juancbarraganp/PROYECTO-SEMINARIO-2026-ECCI/2. Conexiones eléctricas/Tapa Tablero.pdf

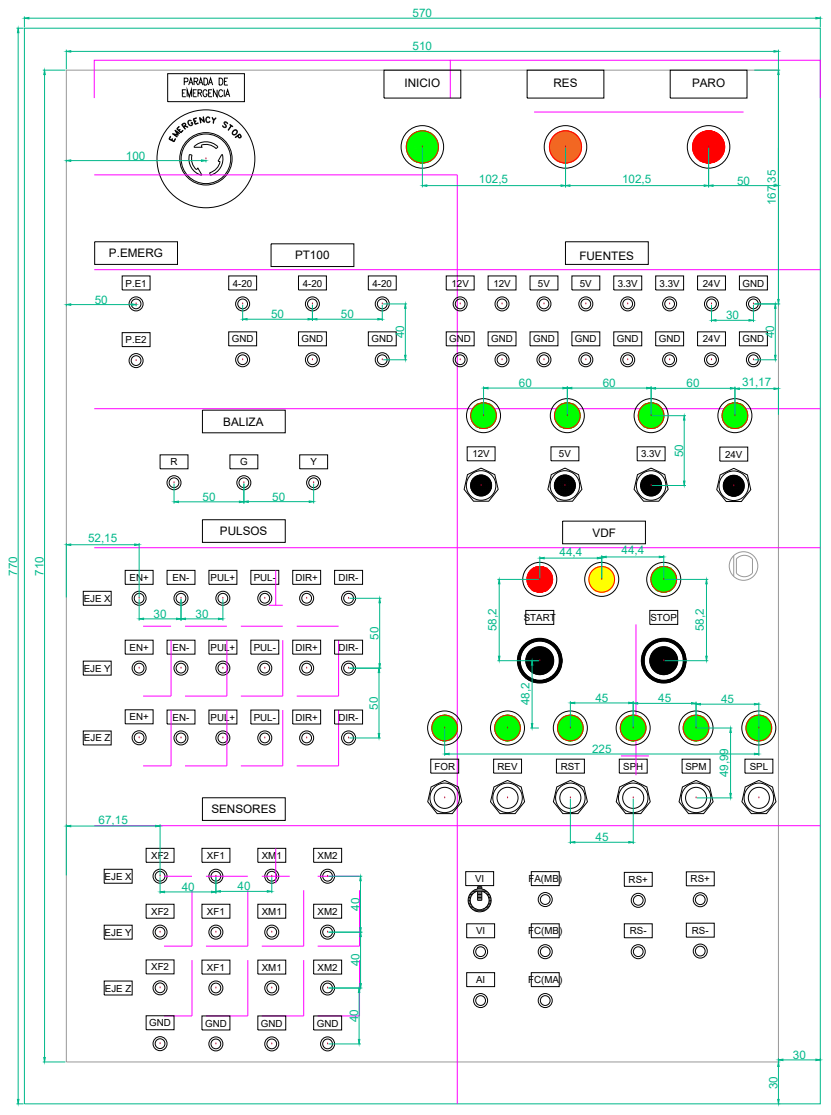
[picture p37: page 1]
INICIO; RES; PARO P.E2 P.E1; PUL+ PUL+; PUL- PUL- EN+; PUL+; PUL- EJE X EJE Y EJE Z; 4-20 GND; 4-20 GND 4-20 GND PULSOS SENSORES; FUENTES BALIZA; VDF 12V GND; 12V GND; 5V GND; 3.3V GND; GND 24V; GND 12V; 24V FOR; REV; RST; SPH; SPM START; STOP VI; XM2 EJE X EJE Y EJE Z P.EMERG; DIR+ DIR+ DIR+; DIR- DIR- DIR- GND; GND; SPL
