juancbarraganp/PROYECTO-SEMINARIO-2026-ECCI/2. Conexiones eléctricas/Planos_seminario_.pdf

| | | | 10/04/2026 | EPLAN Planos electricos proyecto seminario | Universidad ECCI | =
| | | Resp. | juanc | | | +
| | | Probado | | | | 1 | Hoja 0. Portada
Cambio | Fecha | Nombre | Original | | Sustituido por | Sustituido por | | | Página 1 / 13

0

# 1. Distribucion breacker

1 | 2 | 3 | 4 | 5 | 6 | 7 | 8 | 9

# DIAGRAMA ELECTRICO GABINETE DE CONTROL

# INPUT

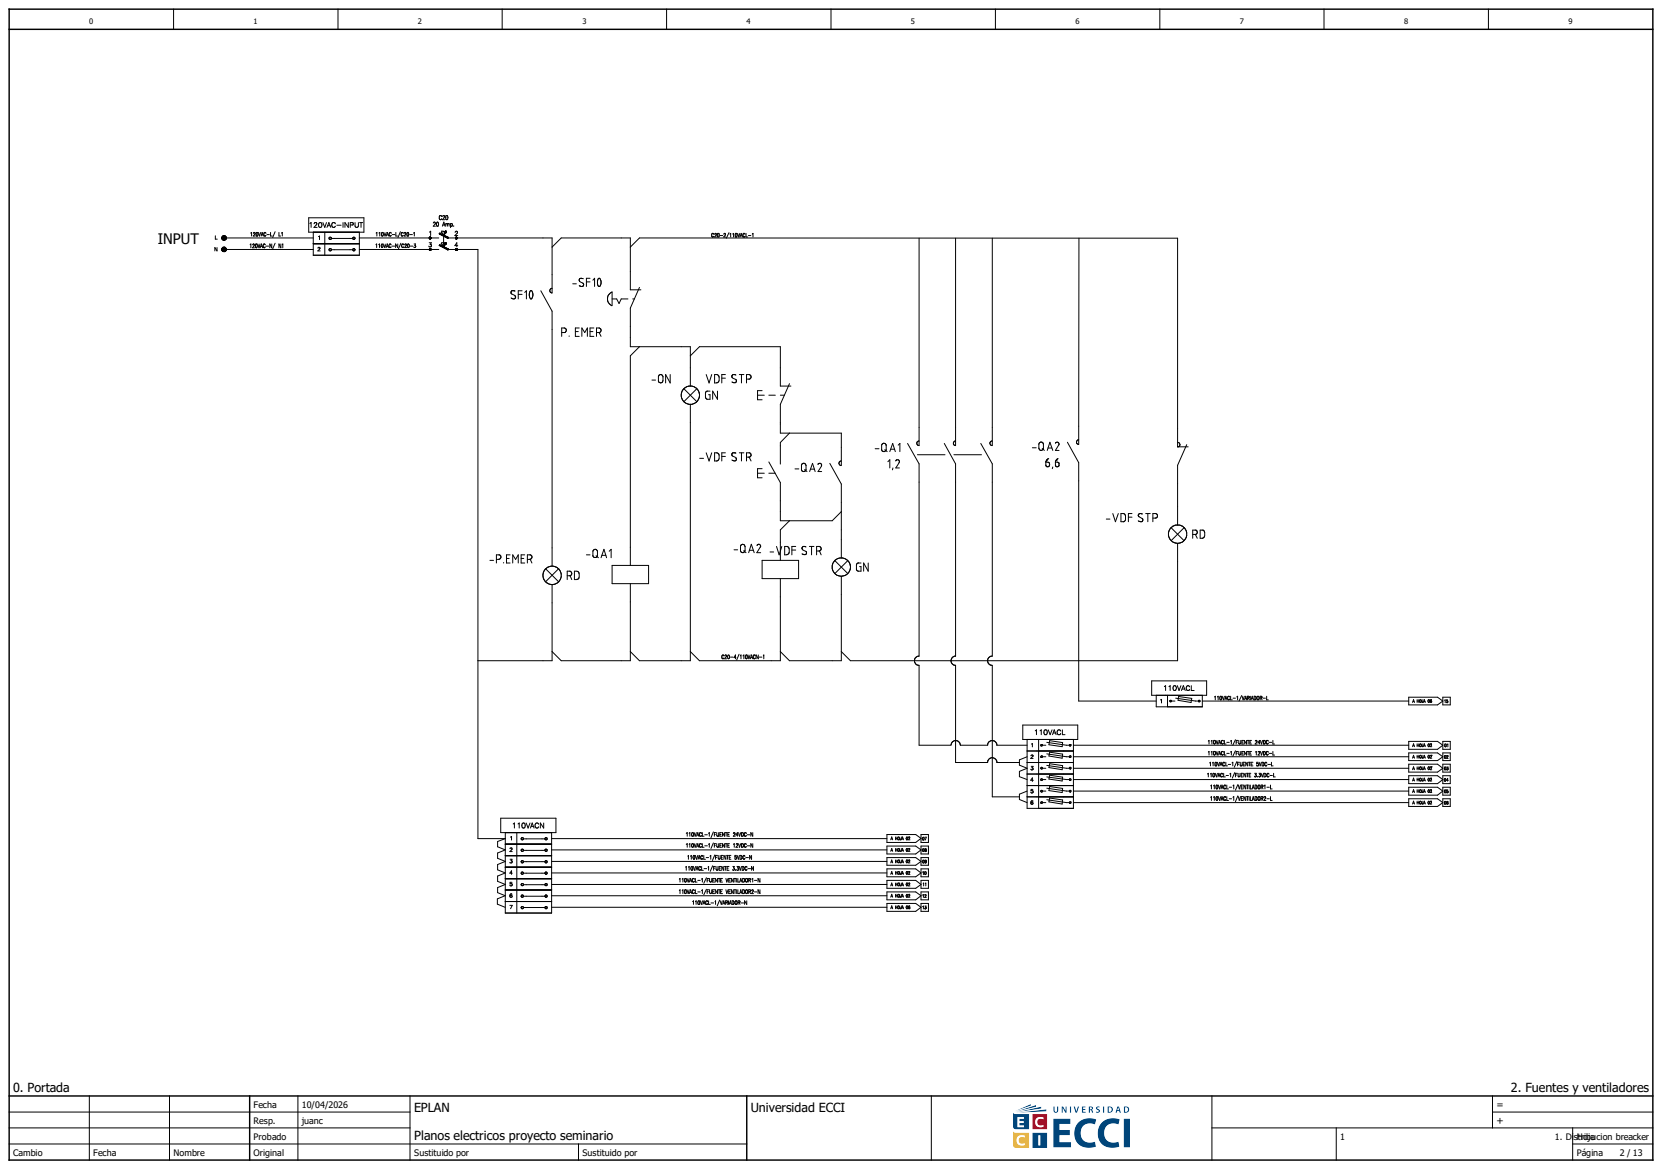
[picture p38: page 2]
0. Portada; 2. Fuentes y ventiladores; 1. Distribucion breacker; Página

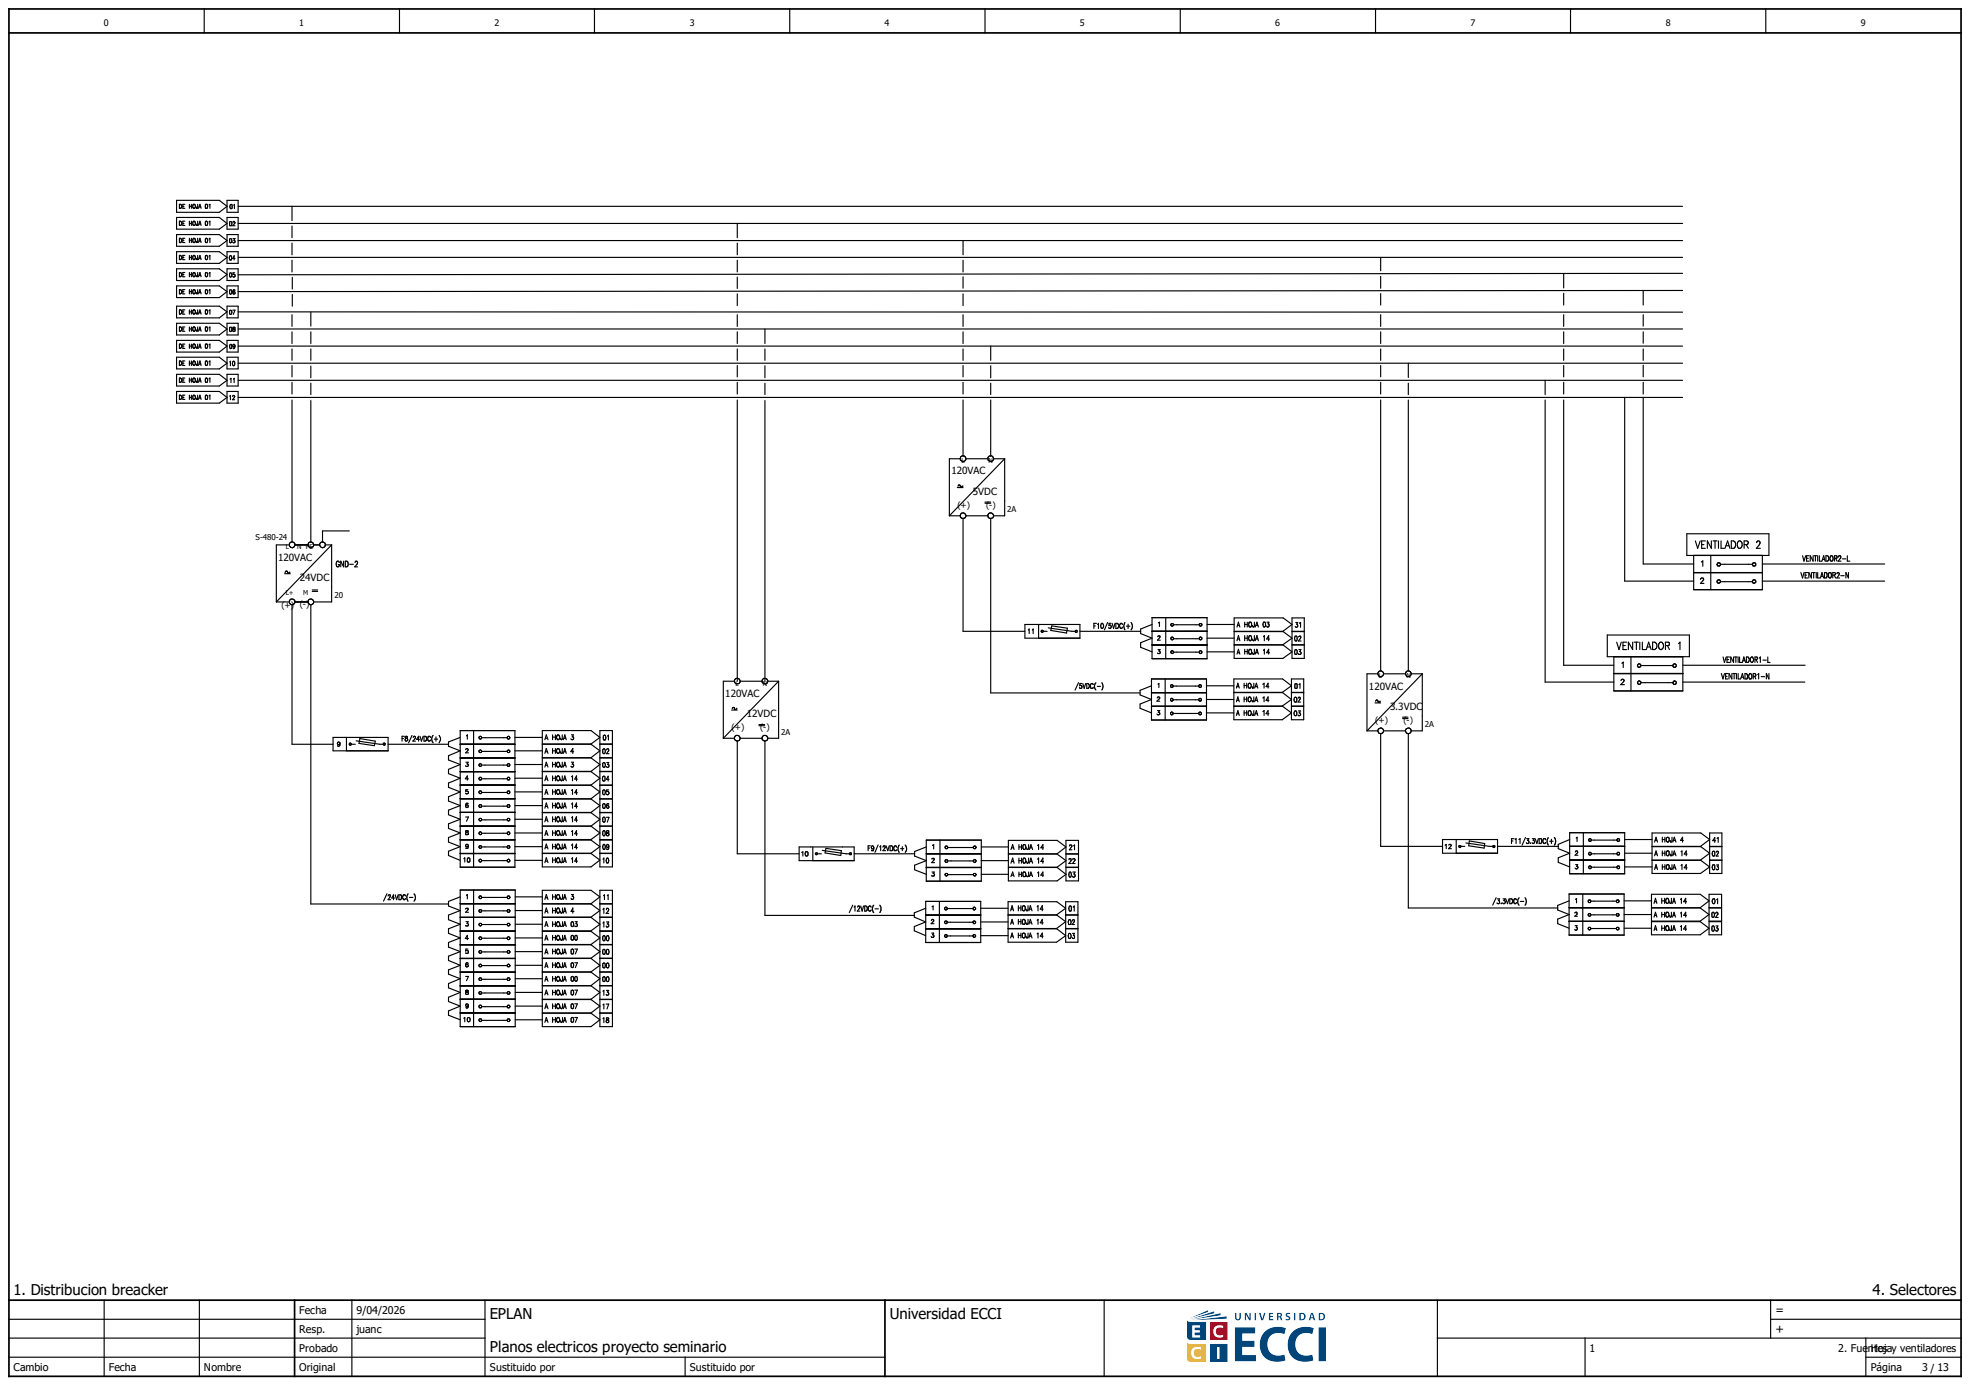
[picture p39: page 3]
1. Distribucion breacker; 4. Selectores; Universidad ECCI; 2. Fuentes y ventiladores; Página; 120VAC; 12VDC; 5VDC; 3.3VDC; 24VDC

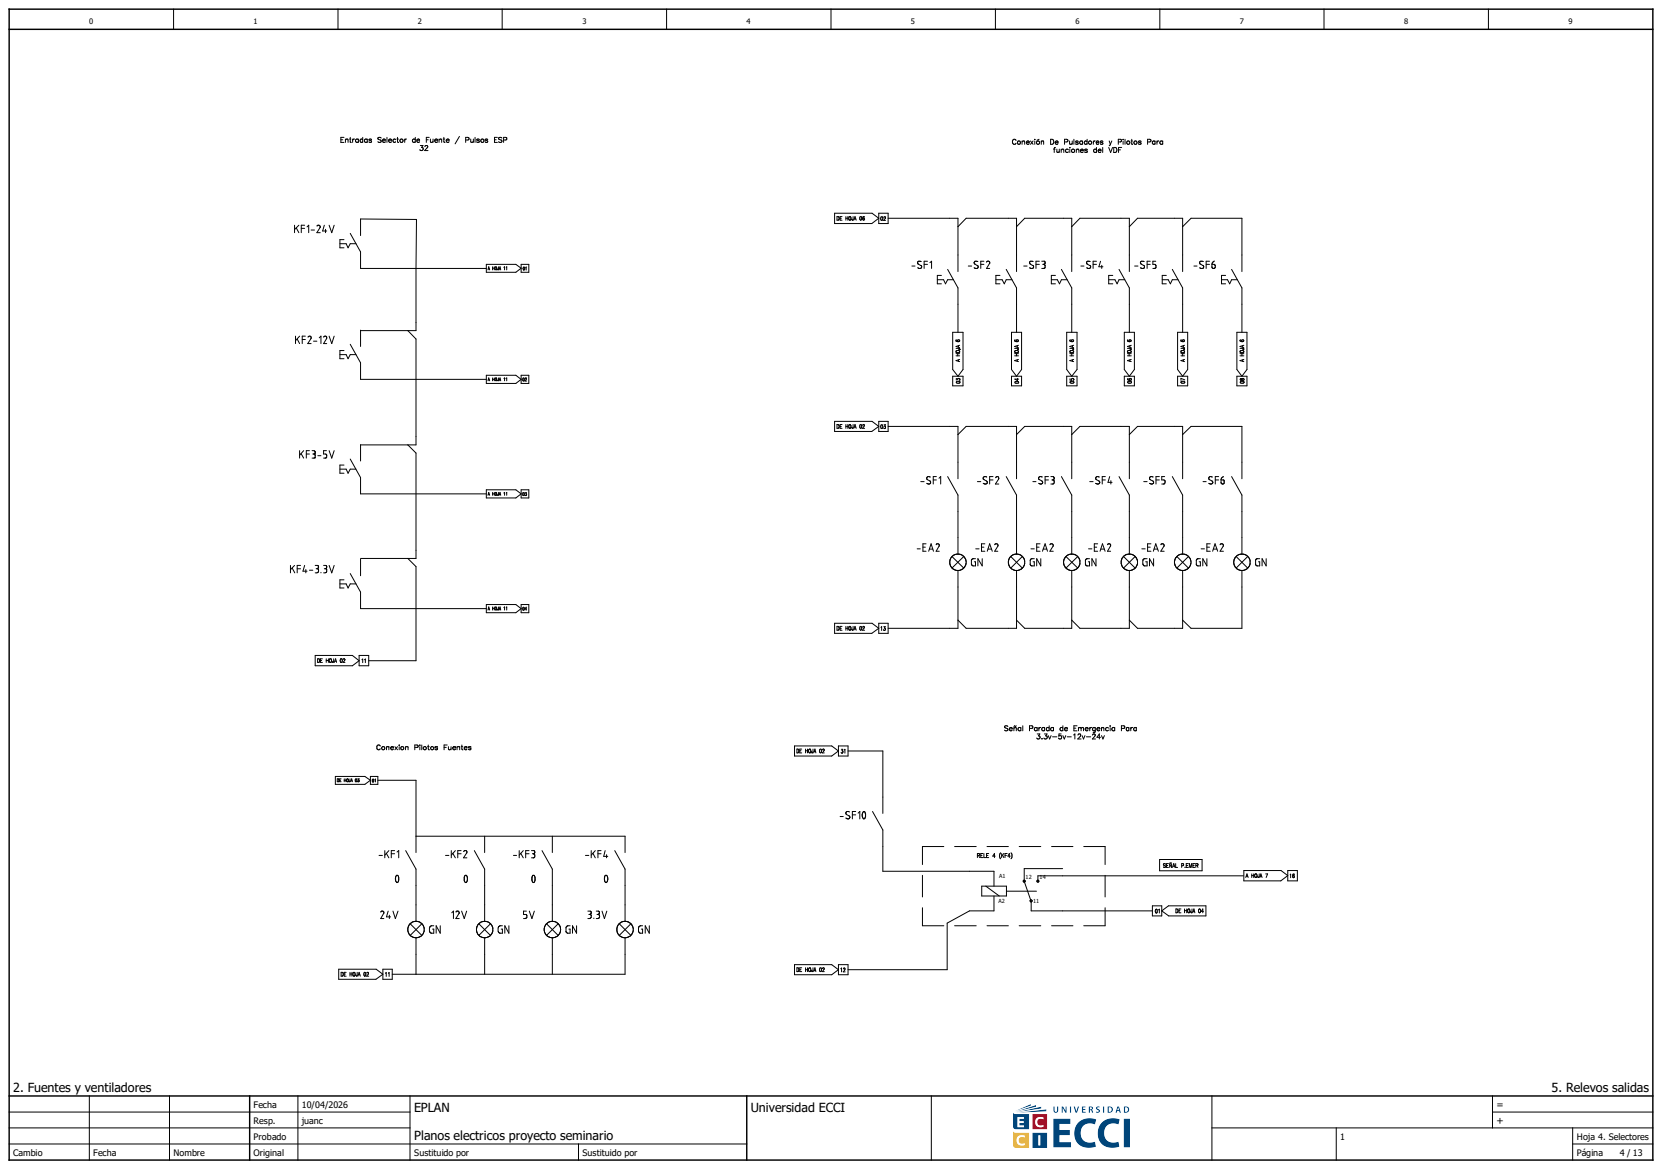
[picture p40: page 4]
2. Fuentes y ventiladores; 5. Relevos salidas; 4. Selectores; Página

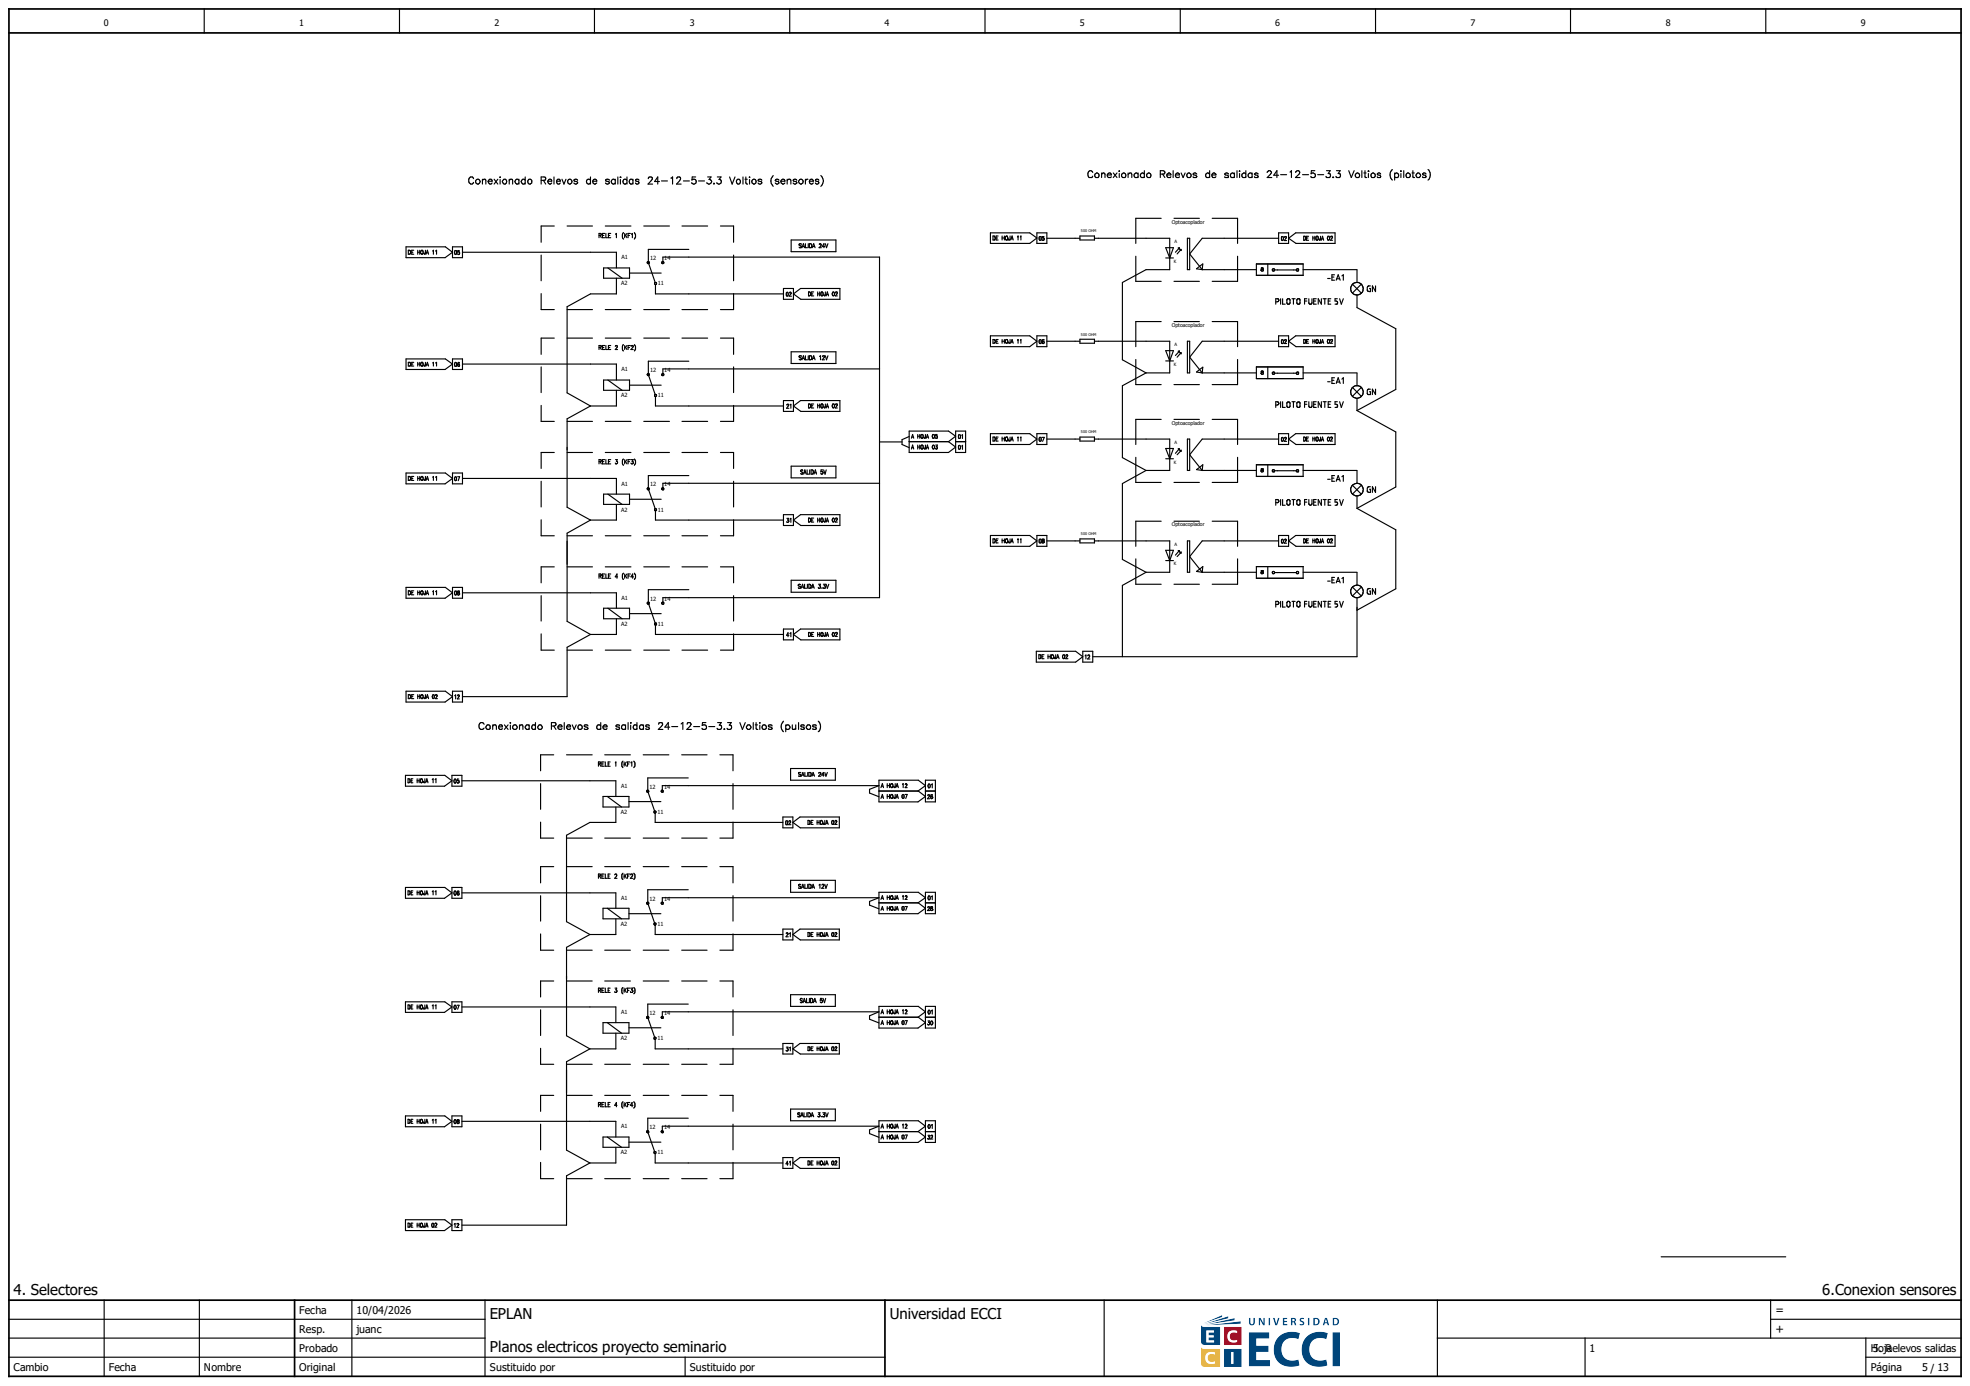
[picture p41: page 5]
4. Selectores; 6.Conexion sensores; 5. Relevos salidas; Página; 500 OHM; Optoacoplador

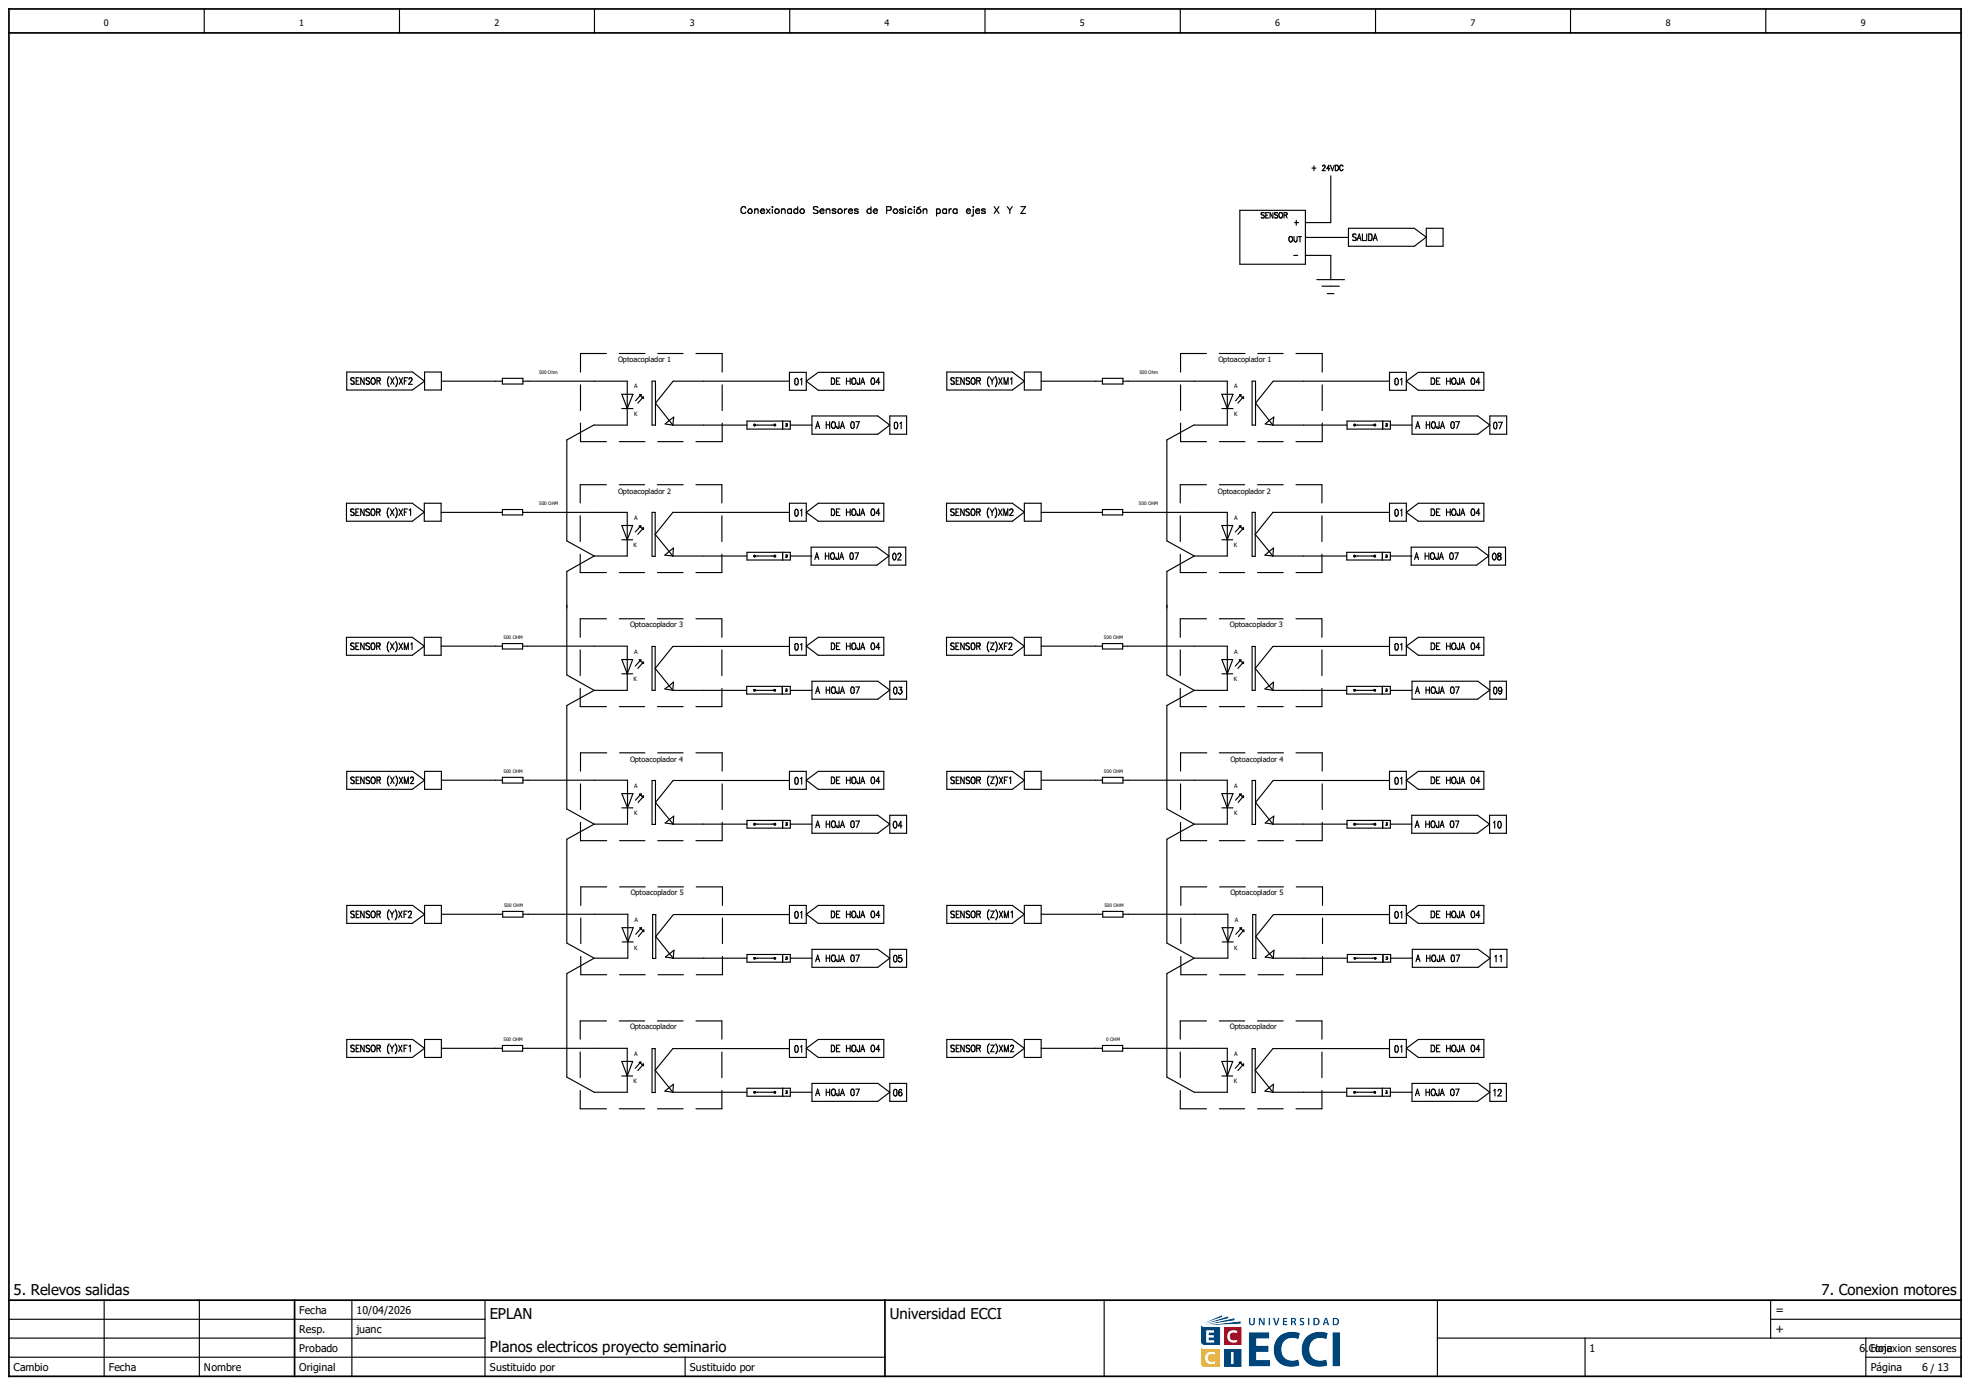
[picture p42: page 6]
5. Relevos salidas; 7. Conexion motores; 6.Conexion sensores; Página; Optoacoplador 1; 500 Ohm; Optoacoplador 2; 500 OHM; Optoacoplador 3; Optoacoplador 4; Optoacoplador 5; Optoacoplador; 0 OHM

R

S

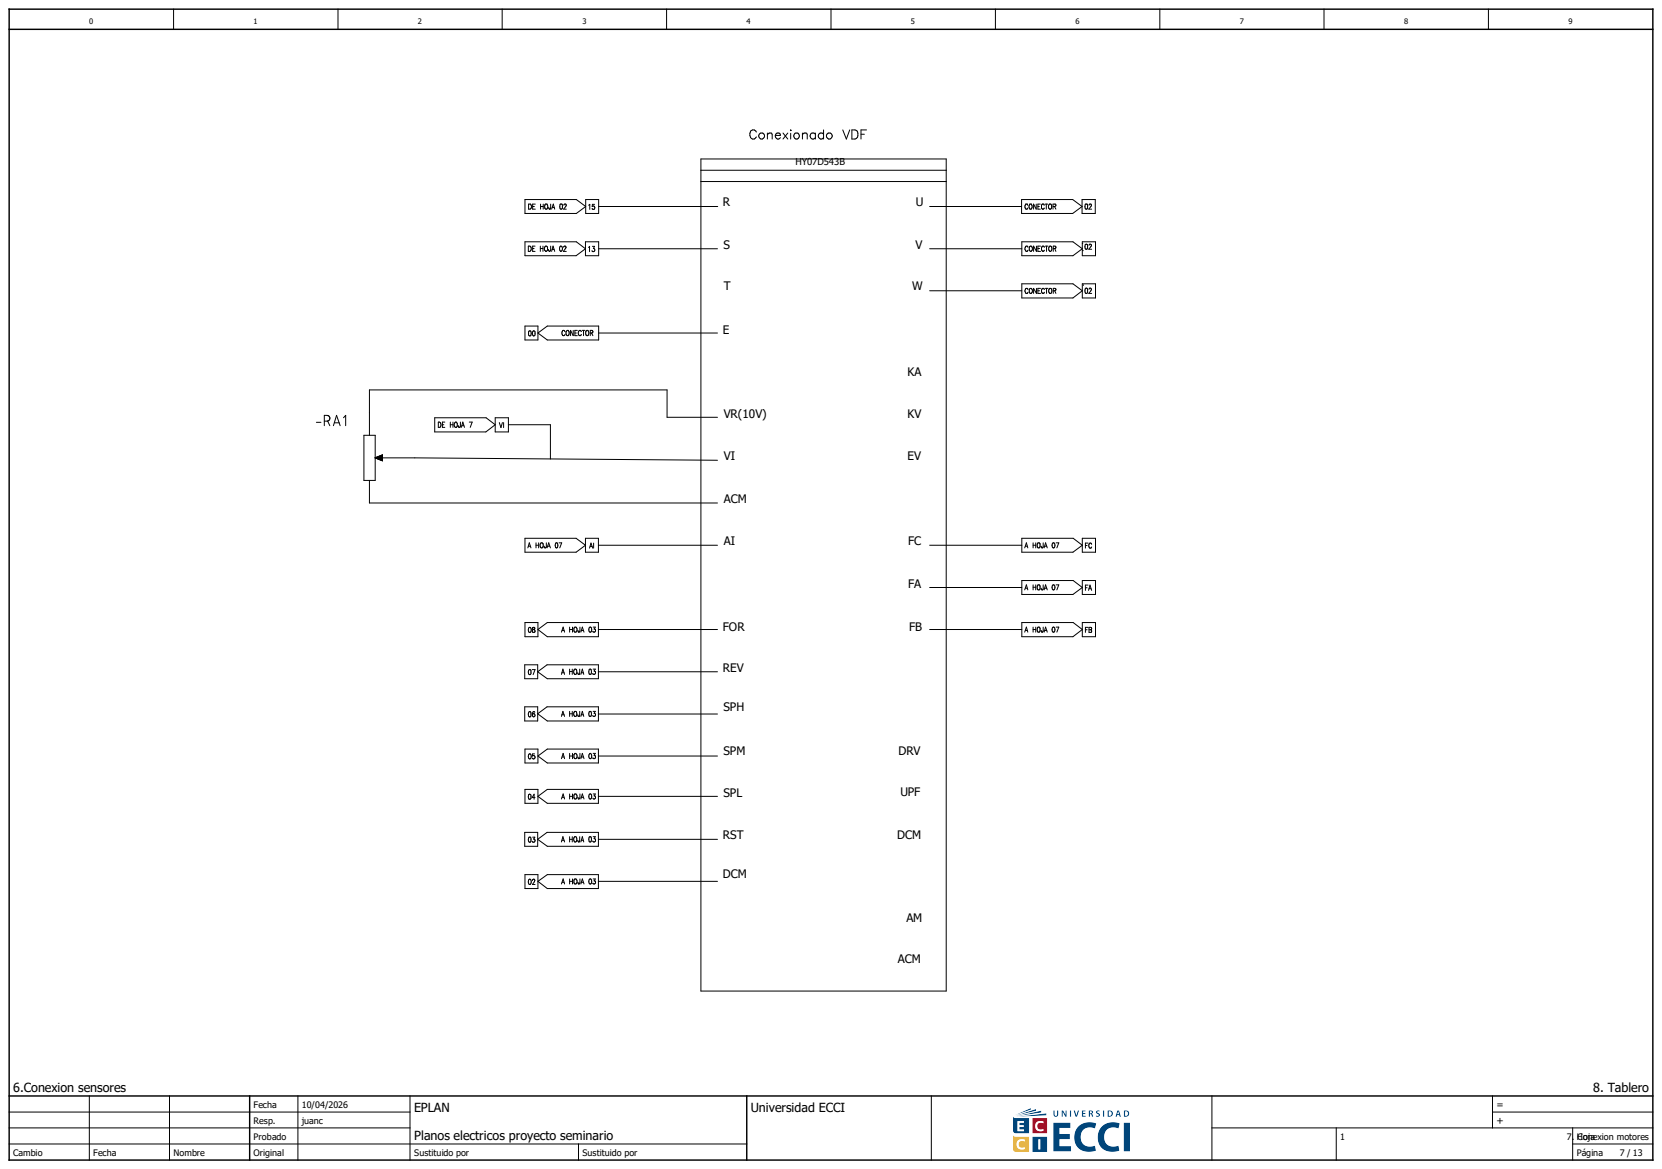
[picture p43: page 7]
6.Conexion sensores; 8. Tablero; 7. Conexion motores; Página; ACM; FOR; REV; SPH; SPM; SPL; RST; DCM; DRV; UPF

ON | FALLO | P.EMER

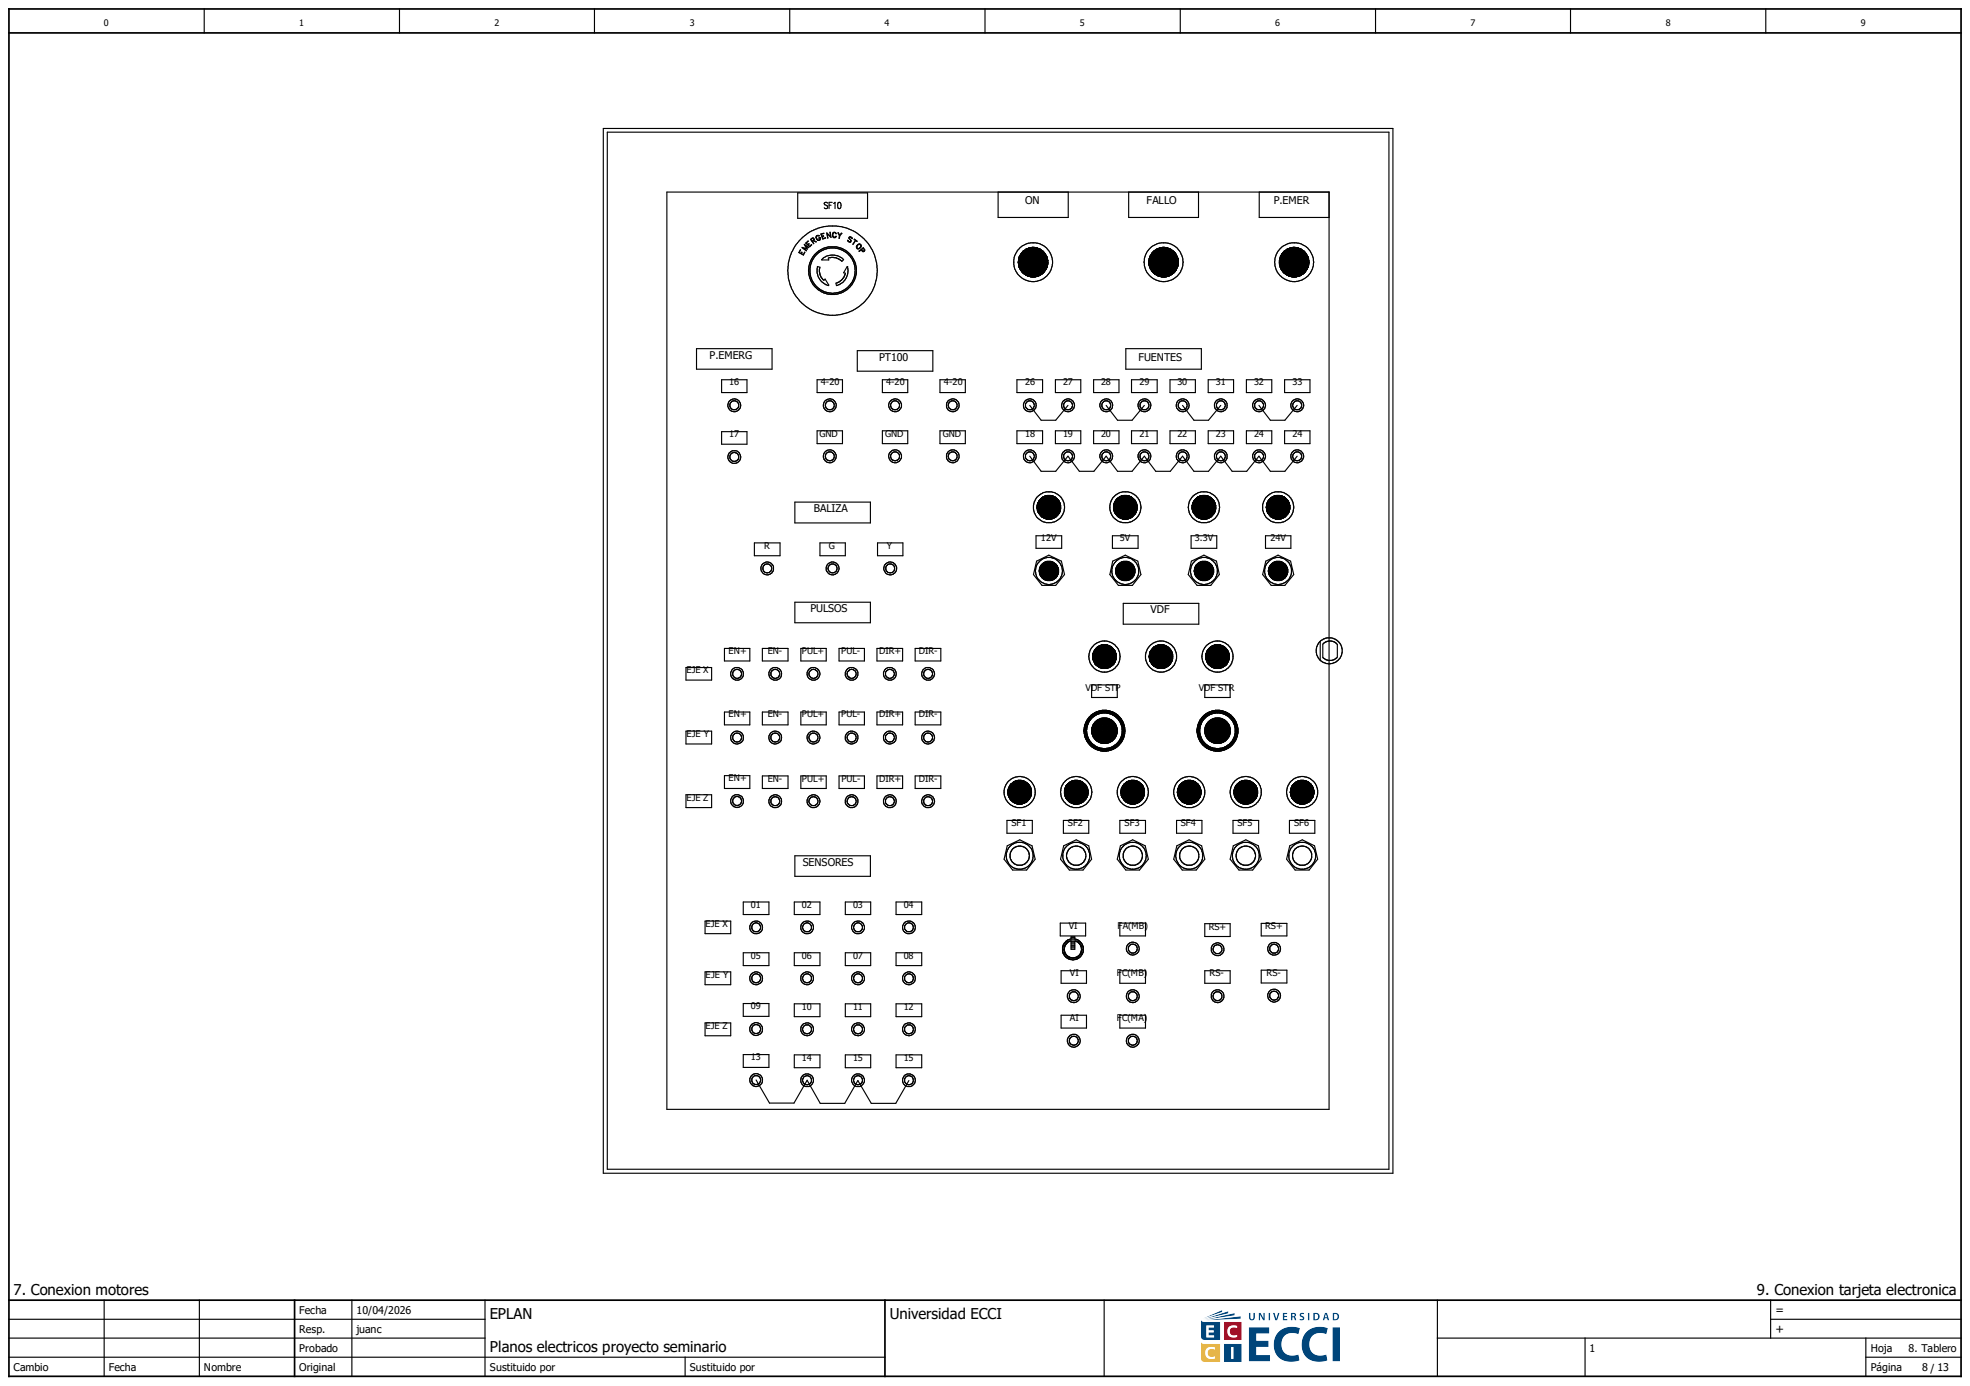
[picture p44: page 8]
7. Conexion motores; 8. Tablero; Página; PUL+; PUL-; EJE X; EJE Y; EJE Z; GND; PULSOS; SENSORES; FUENTES; BALIZA; VDF; VDF STP; VDF STR; P.EMERG; DIR+; DIR-

9. Conexion tarjeta electronica

# ESP -32

# ESP32s

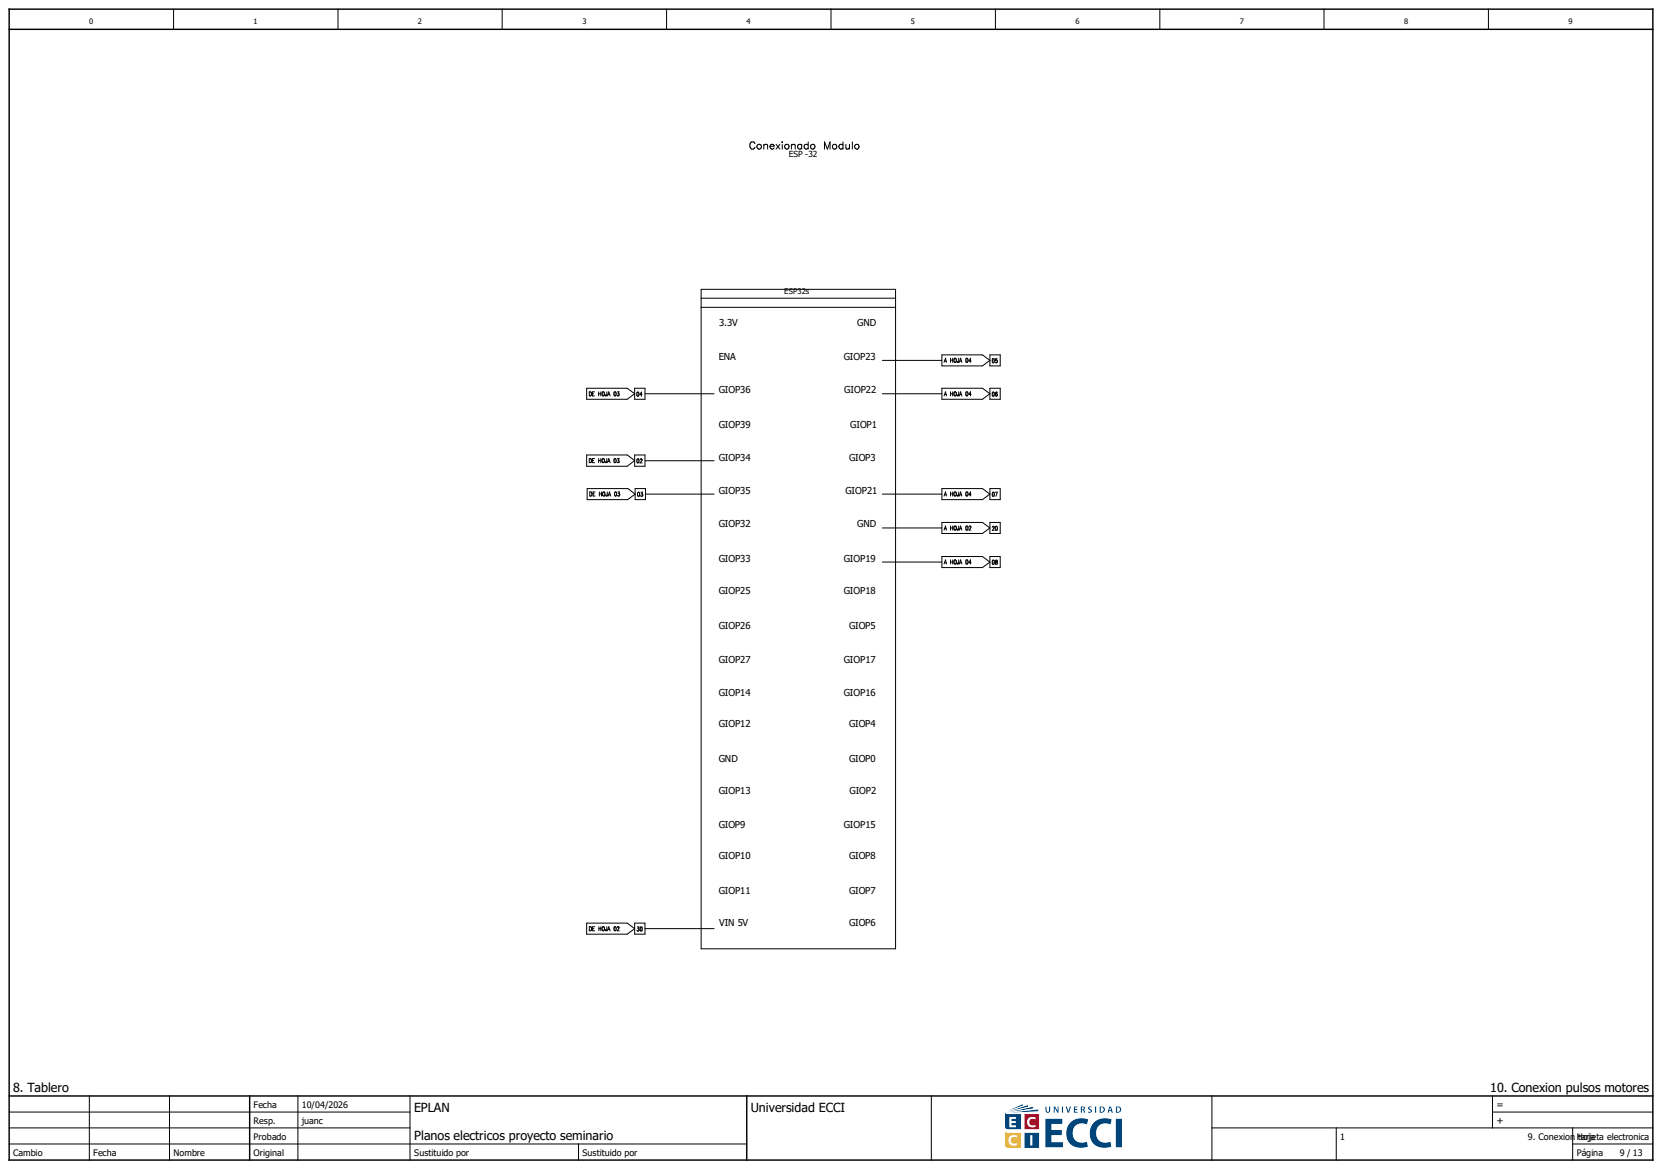
[picture p45: page 9]
8. Tablero; Página; ENA; GIOP36; GIOP39; GIOP34; GIOP35; GIOP32; GIOP33; GIOP25; GIOP26; GIOP27; GIOP14; GIOP12; GND; GIOP13; GIOP9; GIOP10; GIOP11; VIN 5V; GIOP23; GIOP22; GIOP1; GIOP3; GIOP21; GIOP19; GIOP18; GIOP5; GIOP17; GIOP16; GIOP4; GIOP0; GIOP2; GIOP15; GIOP8; GIOP7; GIOP6

10. Conexion pulsos motores

9. Conexion tarjeta electronica

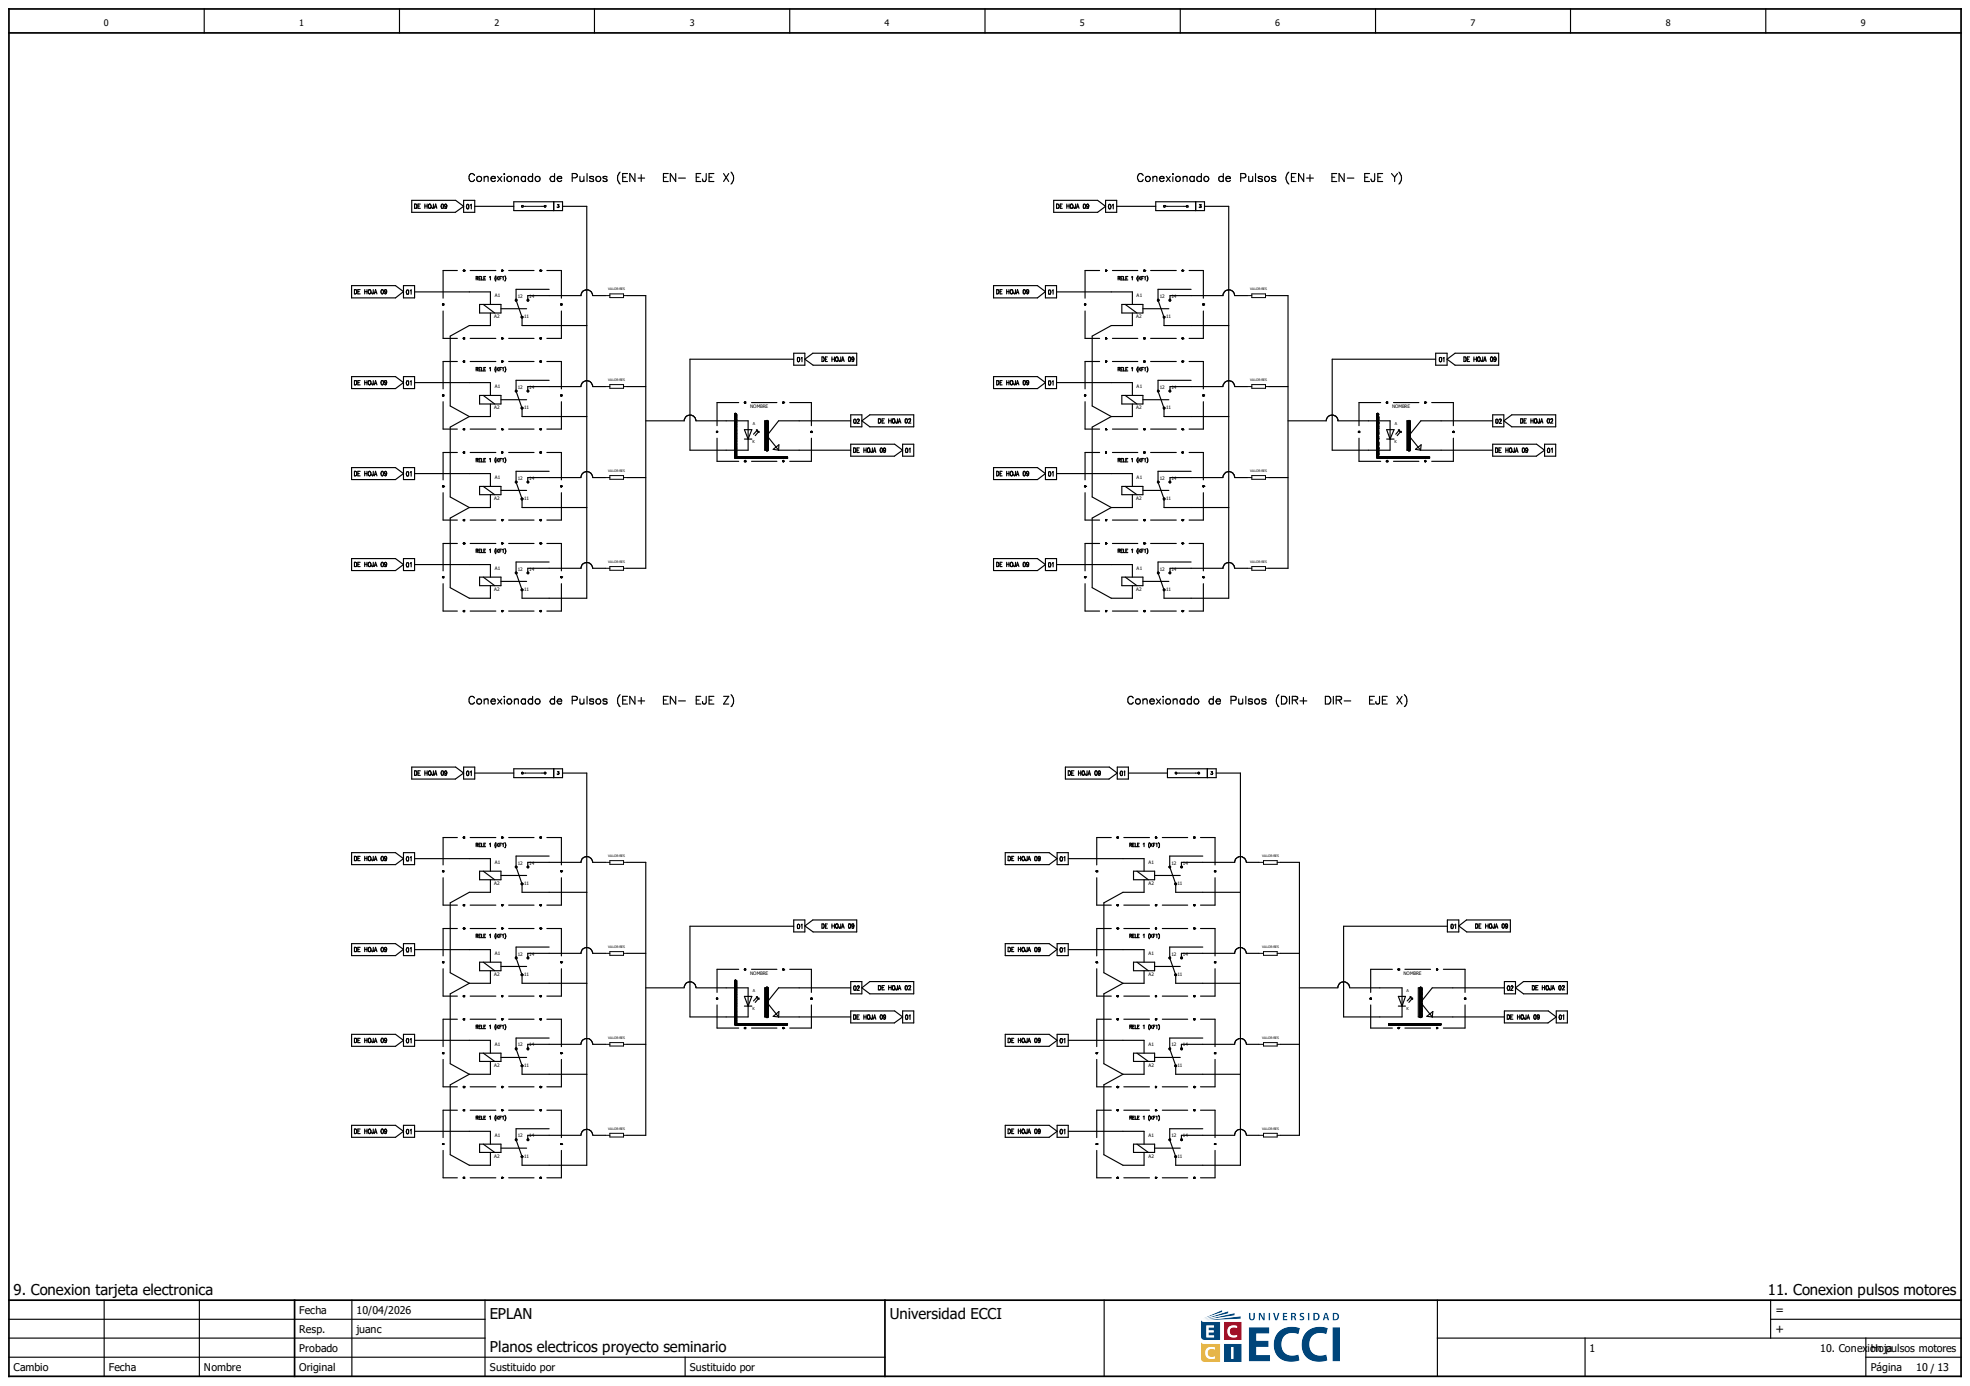
[picture p46: page 10]
Página 10 / 13; VALOR-RES; NOMBRE

9. Conexion tarjeta electronica

11. Conexion pulsos motores

10. Conexion pulsos motores

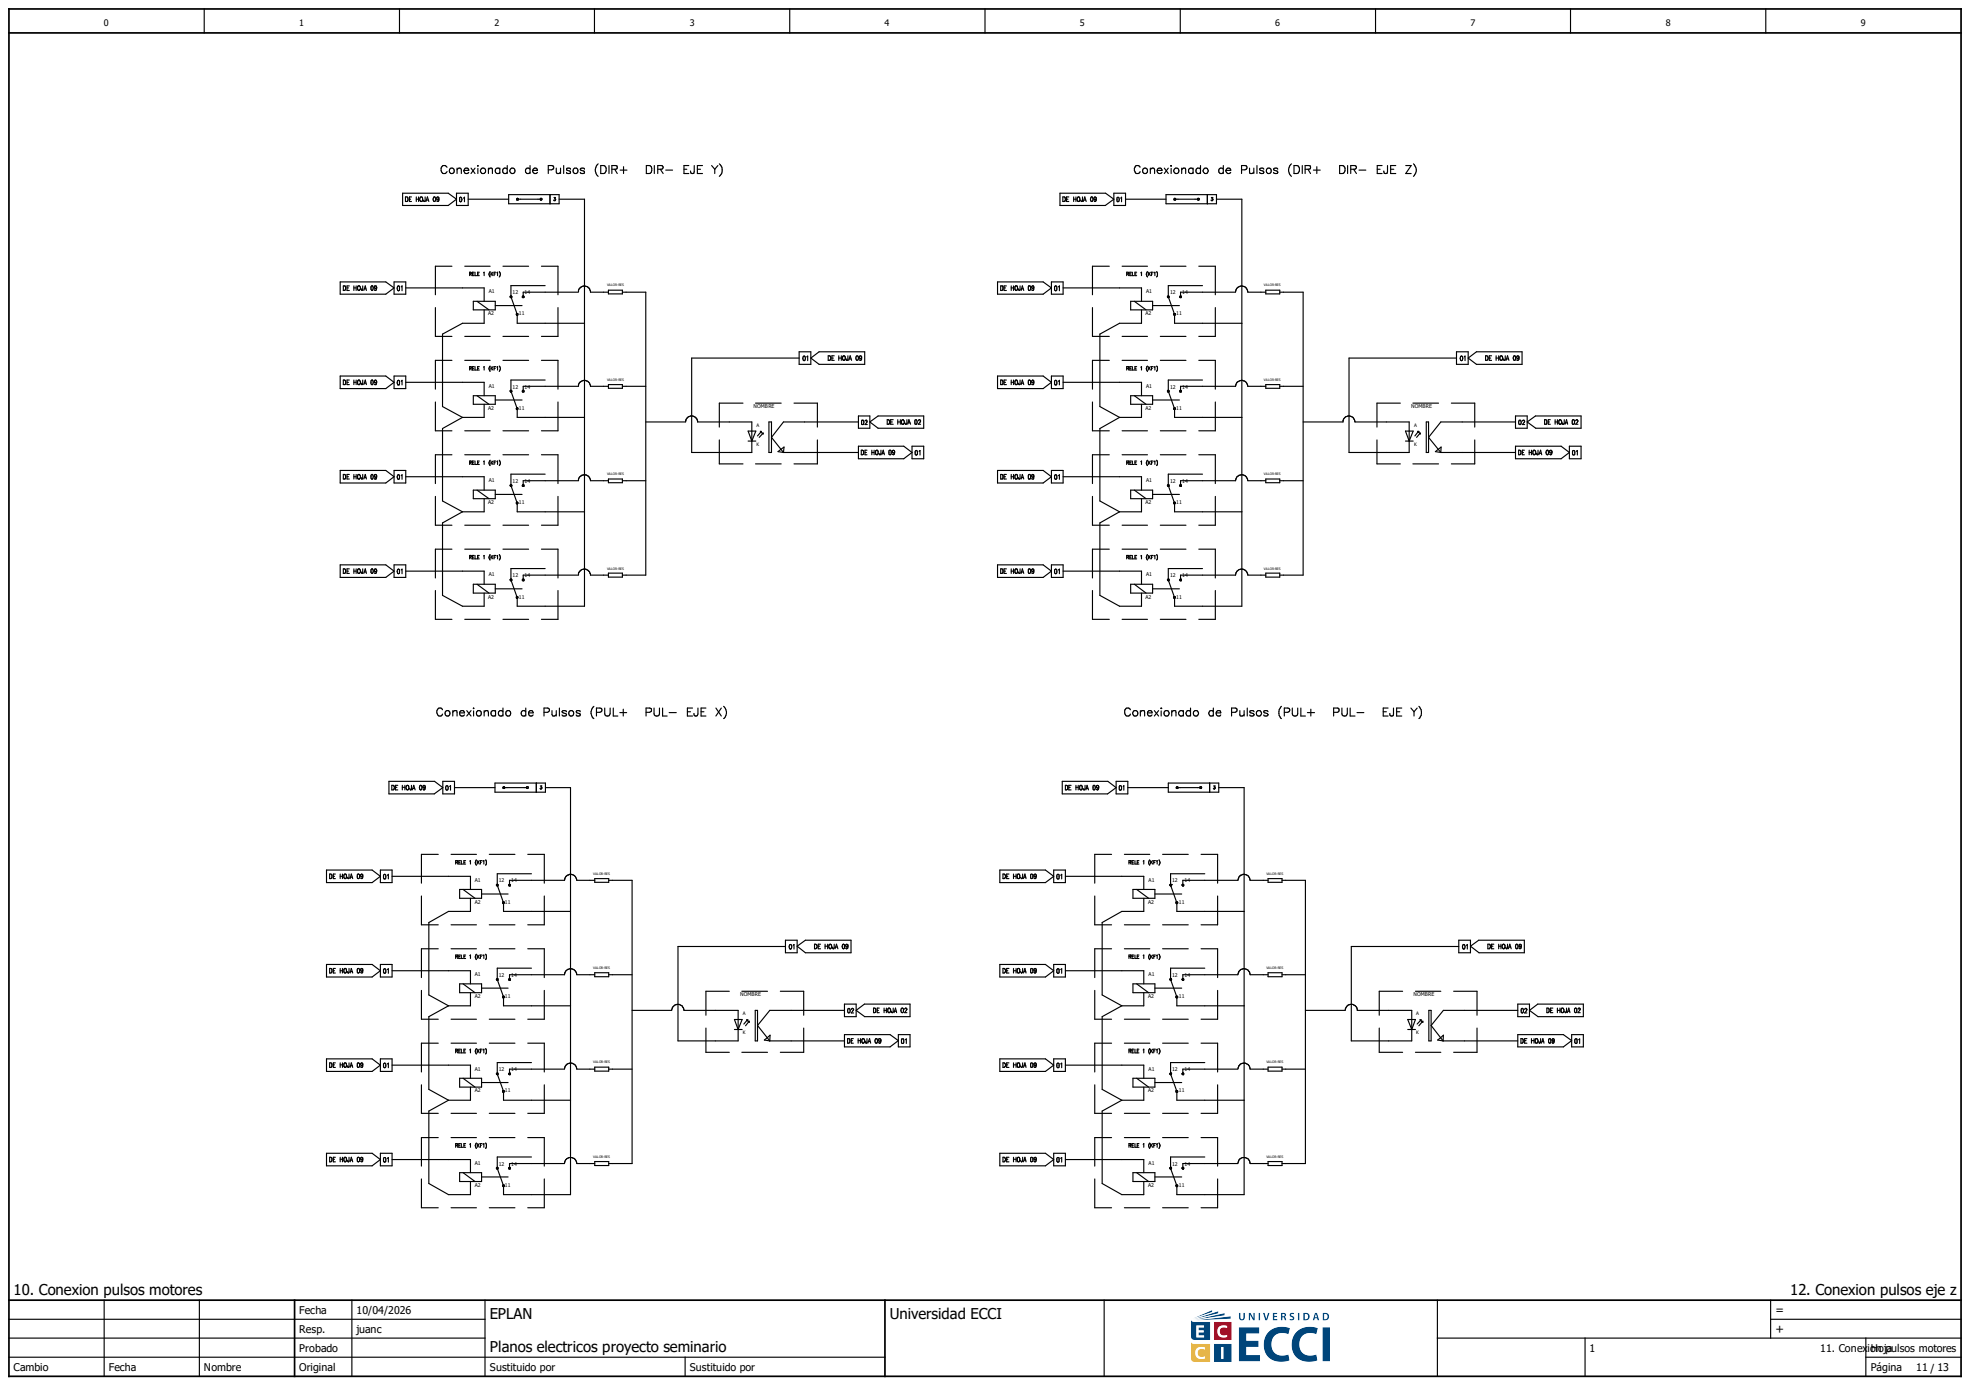
[picture p47: page 11]
Página 11 / 13; VALOR-RES; NOMBRE

10. Conexion pulsos motores

12. Conexion pulsos eje z

11. Conexion pulsos motores

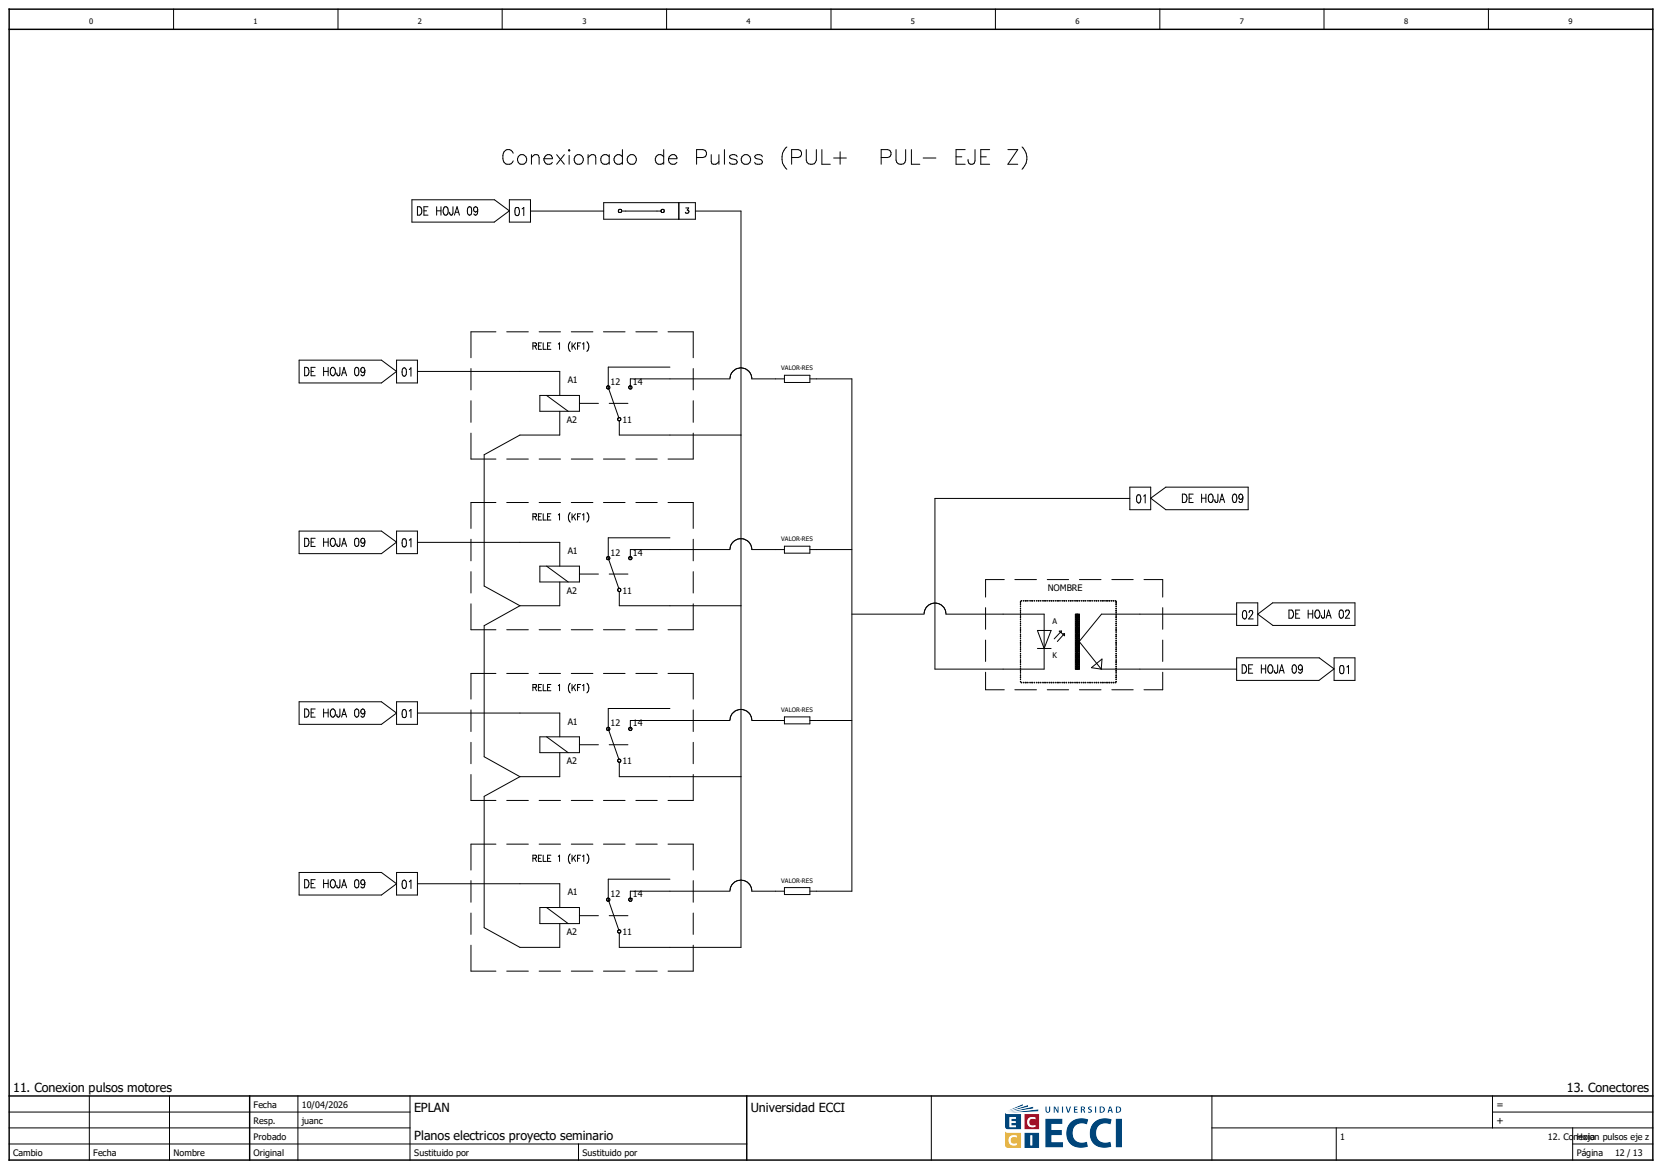
[picture p48: page 12]
13. Conectores; VALOR-RES; NOMBRE

11. Conexion pulsos motores

12. Conexion pulsos eje z
Página 12 / 13

1 -X7 | 2 | 3 | 4

# CONECTOR_1 (SENSORES)

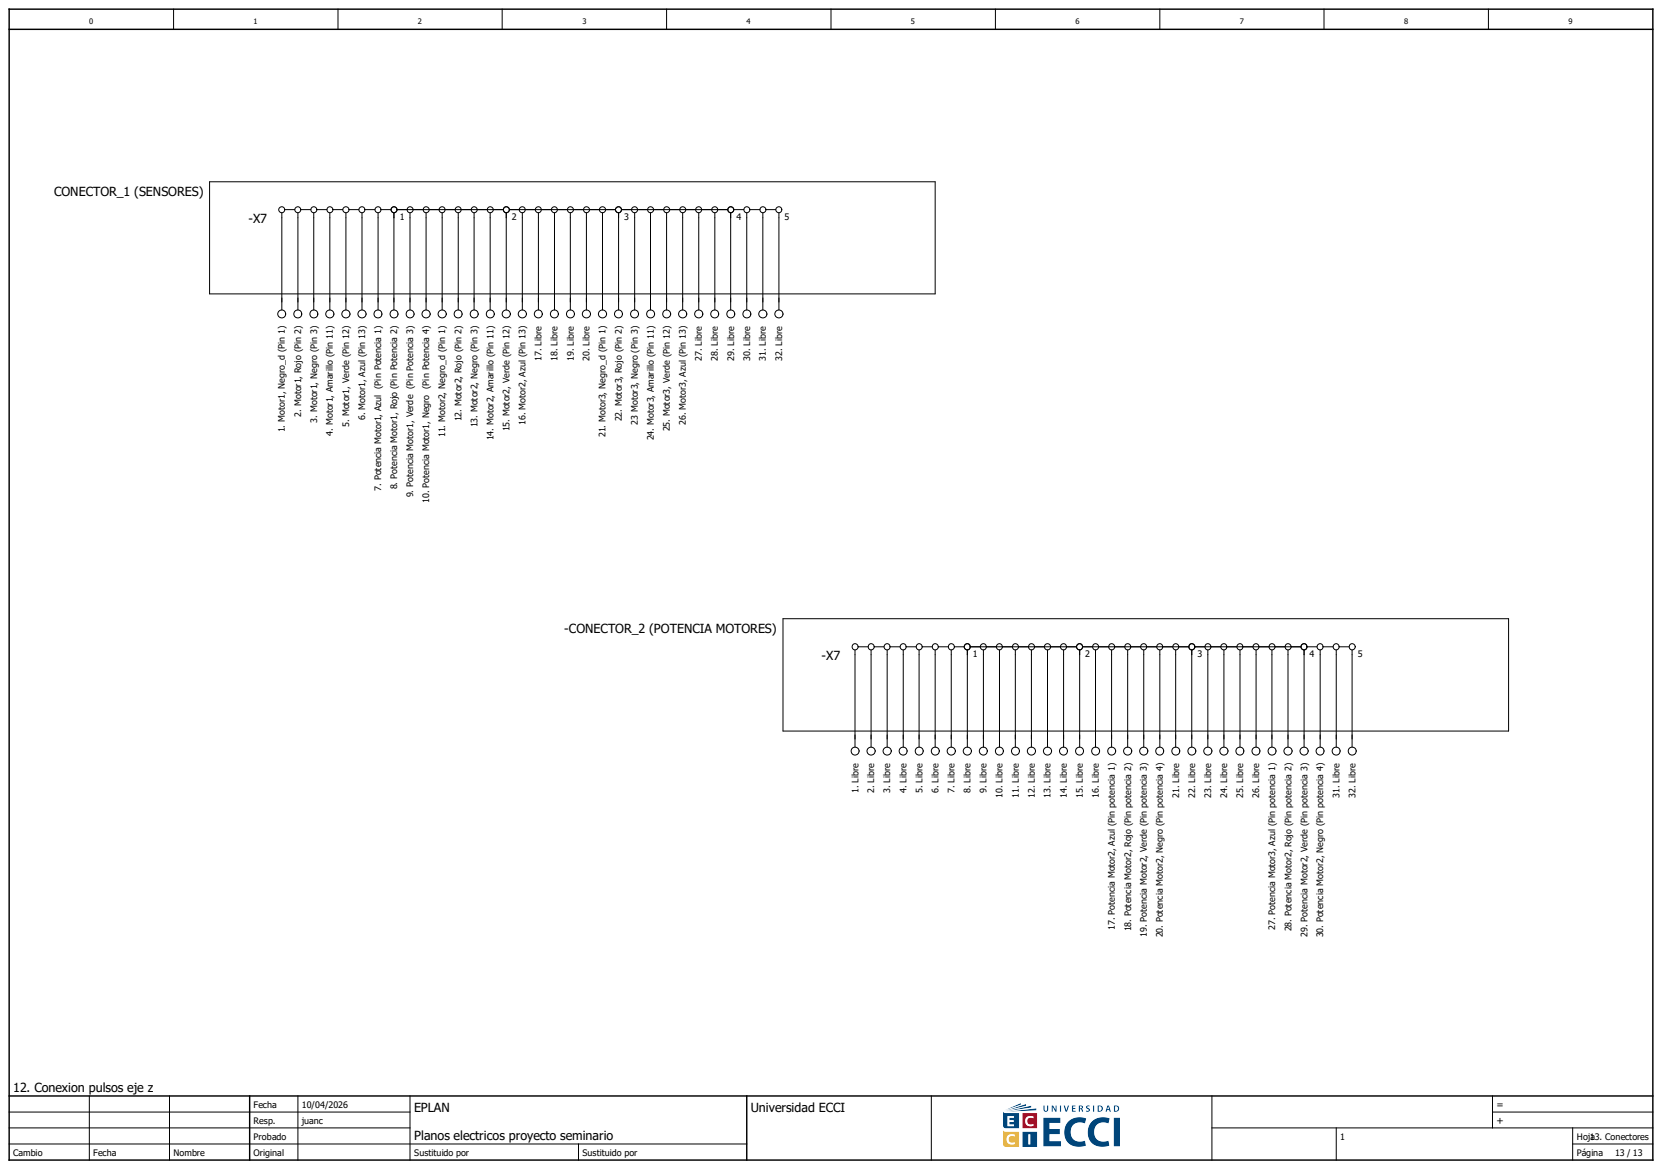
[picture p49: page 13]
13. Conectores Página 13 / 13; -CONECTOR_2 (POTENCIA MOTORES)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

12. Conexion pulsos eje z
